paimonsoror/RxDuino/README.md

RxDuino
=======

The source code for the RxDuino has now entered open source.  For more information please visit the RxDuino website
