paimonsoror/RxDuino/RxDuinoSch/RxDuino_Rev4b.brd

## EAGLE design RxDuinoSch/RxDuino_Rev4b.brd (2013-07-08)

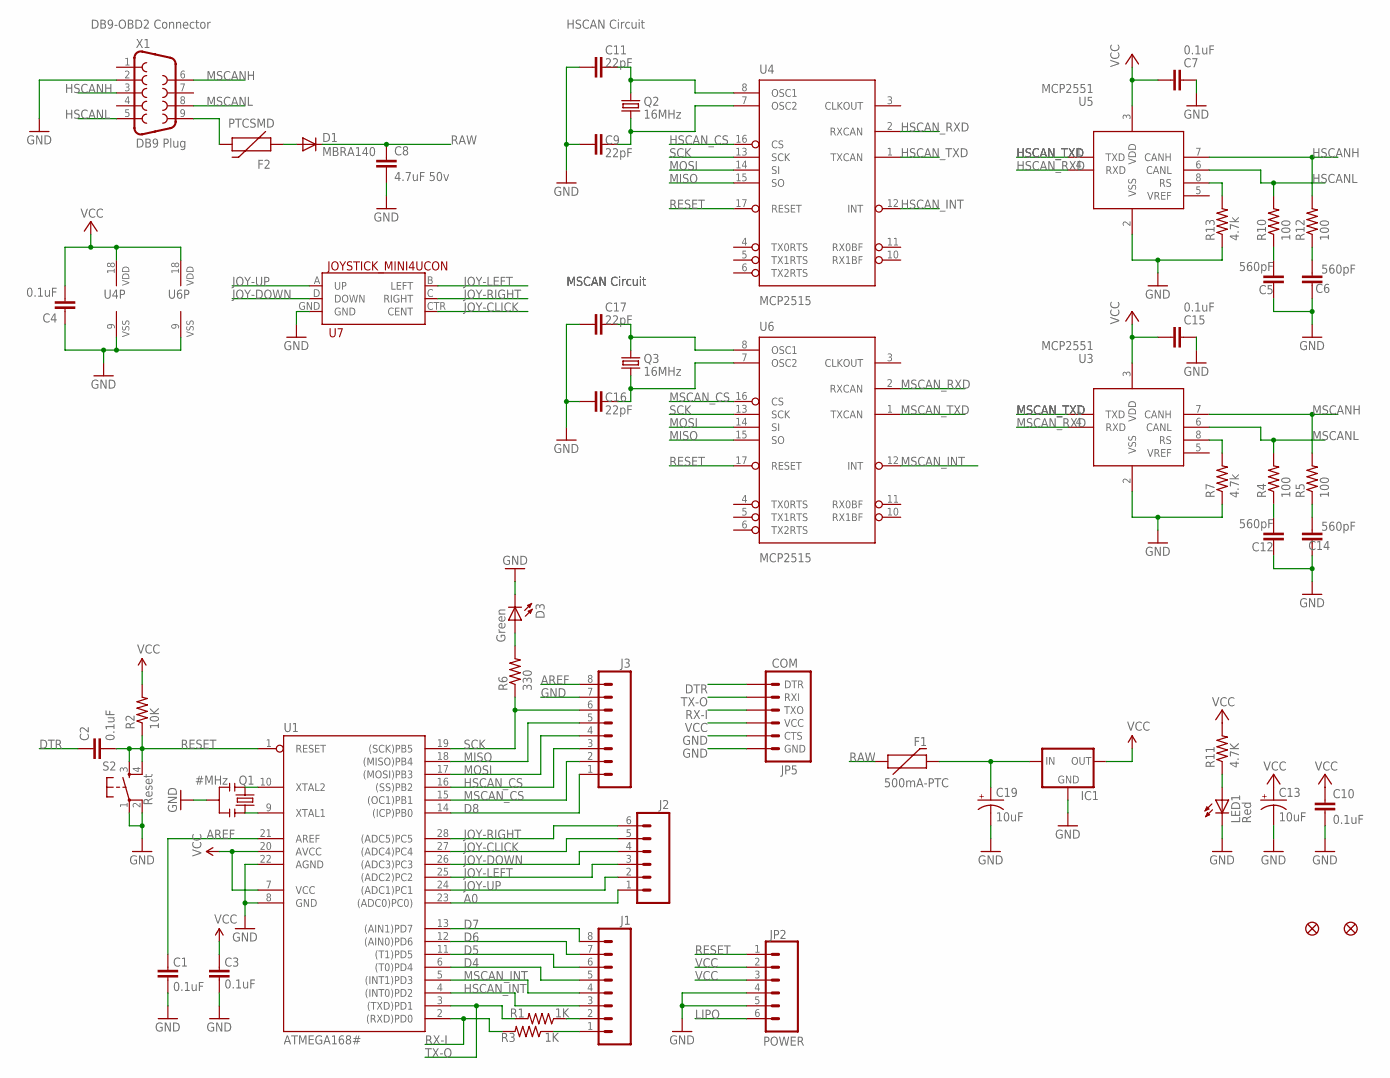
[picture p1: schematic RxDuino_Rev4b.sch]

Parts:
C1, C2, C3, C4, C7, C10, C15: 0.1uF; 1206
C5, C6, C12, C14: 560pF; 1206
C8: 4.7uF 50v; 1206
C9, C11, C16, C17: 22pF; 1206
C13, C19: 10uF; PANASONIC_E
D1: MBRA140; SMA-DIODE
D3: Green; LED-1206
F1: 500mA-PTC; PTC-1206
F2: PTCSMD; PTC-1206
IC1: V_REG_78XX-TO-220; TO-220-ALT
J1, J3: M08; 1X08
J2: M06SIP; 1X06
JP2: POWER; 1X06
JP5: COM; 1X06
LED1: Red; LED-1206
Q1: #MHz; RESONATOR-PTH
Q2, Q3: 16MHz; HC49US
R1, R3: 1K; 1206
R2: 10K; 1206
R4, R5, R10, R12: 100; 1206
R6: 330; 1206
R7, R13: 4.7k; 1206
R11: 4.7K; 1206
S2: Reset; TACTILE_SWITCH_SMD
U1: ATMEGA168#; DIL28-3
U3, U5: MCP2551; SO-08M
U4, U6: MCP2515; SO-18W
U7: JOYSTICK_MINI4UCON; JOYSTICK_MINI
U$2, U$4: FIDUCIAL1X2; FIDUCIAL-1X2
X1: DB9 Plug; DB9_MALE

Connections:
A0: J2.1, U1.23 ((ADC0)PC0))
AREF: C1.2, J3.8, U1.21 (AREF)
D1R: D1.A, F2.1
D3N: D3.A, R6.2
D4: J1.5, U1.6 ((T0)PD4)
D5: J1.6, U1.11 ((T1)PD5)
D6: J1.7, U1.12 ((AIN0)PD6)
D7: J1.8, U1.13 ((AIN1)PD7)
D8: J3.1, U1.14 ((ICP)PB0)
DTR: C2.1, JP5.1 (DTR)
GND: C1.1, C3.1, C4.1, C5.1, C6.1, C7.1, C8.2, C9.1, C10.2, C11.1, C12.1, C13.-, C14.1, C15.1, C16.1, C17.1, C19.-, D3.C, IC1.GND, J3.7, JP2.4, JP2.5, JP5.5 (CTS), JP5.6 (GND), LED1.C, Q1.2, R7.1, R13.1, S2.1, S2.2, U1.8 (GND), U1.22 (AGND), U3.2 (VSS), U4.9 (VSS), U5.2 (VSS), U6.9 (VSS), U7.GND, X1.2
HSCANH: R12.2, U5.7 (CANH), X1.3
HSCANL: R10.2, U5.6 (CANL), X1.5
HSCAN_CS: J3.3, U1.16 ((SS)PB2), U4.16 (CS)
HSCAN_INT: J1.3, U1.4 ((INT0)PD2), U4.12 (INT)
HSCAN_RXD: U4.2 (RXCAN), U5.4 (RXD)
HSCAN_TXD: U4.1 (TXCAN), U5.1 (TXD)
HSQ1: C11.2, Q2.2, U4.8 (OSC1)
HSQ2: C9.2, Q2.1, U4.7 (OSC2)
HSRS: R13.2, U5.8 (RS)
JOY-CLICK: J2.5, U1.27 ((ADC4)PC4), U7.CTR (CENT)
JOY-DOWN: J2.4, U1.26 ((ADC3)PC3), U7.D (DOWN)
JOY-LEFT: J2.3, U1.25 ((ADC2)PC2), U7.B (LEFT)
JOY-RIGHT: J2.6, U1.28 ((ADC5)PC5), U7.C (RIGHT)
JOY-UP: J2.2, U1.24 ((ADC1)PC1), U7.A (UP)
LIPO: JP2.6
MEGAP9: Q1.3, U1.9 (XTAL1)
MEGAP10: Q1.1, U1.10 (XTAL2)
MISO: J3.5, U1.18 ((MISO)PB4), U4.15 (SO), U6.15 (SO)
MOSI: J3.4, U1.17 ((MOSI)PB3), U4.14 (SI), U6.14 (SI)
MSCANH: R5.2, U3.7 (CANH), X1.6
MSCANL: R4.2, U3.6 (CANL), X1.8
MSCAN_CS: J3.2, U1.15 ((OC1)PB1), U6.16 (CS)
MSCAN_INT: J1.4, U1.5 ((INT1)PD3), U6.12 (INT)
MSCAN_RXD: U3.4 (RXD), U6.2 (RXCAN)
MSCAN_TXD: U3.1 (TXD), U6.1 (TXCAN)
MSQ1: C17.2, Q3.2, U6.8 (OSC1)
MSQ2: C16.2, Q3.1, U6.7 (OSC2)
MSRS: R7.2, U3.8 (RS)
PTCN: F2.2, X1.9
R4N: C12.2, R4.1
R5N: C14.2, R5.1
R10N: C5.2, R10.1
R11N: LED1.A, R11.1
R12N: C6.2, R12.1
RAW: C8.1, D1.C, F1.1
RAWN: C19.+, F1.2, IC1.IN
RESET: C2.2, JP2.1, R2.1, S2.3, S2.4, U1.1 (RESET), U4.17 (RESET), U6.17 (RESET)
RX-I: JP5.3 (TXO), R3.2, U1.2 ((RXD)PD0)
RX-IP: J1.2, R1.1
SCK: J3.6, R6.1, U1.19 ((SCK)PB5), U4.13 (SCK), U6.13 (SCK)
TX-O: JP5.2 (RXI), R1.2, U1.3 ((TXD)PD1)
TX-OP: J1.1, R3.1
VCC: C3.2, C4.2, C7.2, C10.1, C13.+, C15.2, IC1.OUT, JP2.2, JP2.3, JP5.4 (VCC), R2.2, R11.2, U1.7 (VCC), U1.20 (AVCC), U3.3 (VDD), U4.18 (VDD), U5.3 (VDD), U6.18 (VDD)

Notes on the sheet:
MSCAN Circuit
HSCAN Circuit
DB9-OBD2 Connector

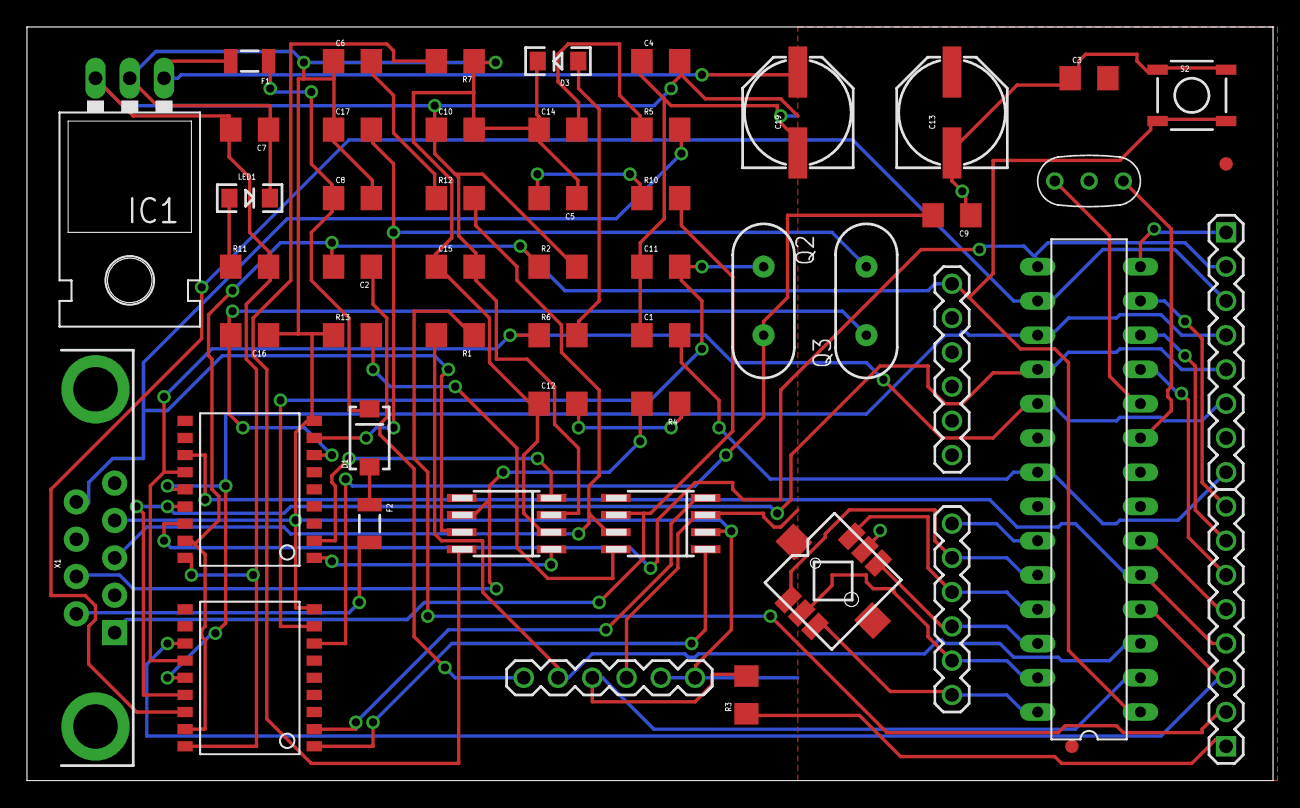
[picture p2: board RxDuino_Rev4b.brd from above]

Board: 2 copper layers, 92.4 x 55.9 mm, 53 parts (0 on the bottom side), 53 nets.
