paimonsoror/RxDuino/(notices)

Notices in the files:
RxDuinoLibs/src/canbus_message.cpp:
RXDUINO Software, All Rights Reserved 2012
